linfenggg/aom_sync_clock/README.txt

2024-10-31  LD_CUR_FACTOR 值由2.5->2.9   因为DAC比例问题调整
