linfenggg/aom_sync_clock/User/readme.txt

//v1
初版

//v2
1.ld1通道切换
2.pwm 起始给个30%占空比,避免进入休眠模式
3.增加pwm下限
