linfenggg/aom_sync_clock/CTRL_V2 OPA-20260515/_版本说明.txt

//-------------MASTER_FPGA_V2103------------
1.模拟量一直输出，用TTL信号来选单
//-------------MASTER_FPGA_V2104------------
1.慢开慢关，一键开关调试
//-------------MASTER_FPGA_V2105------------
1.增加常规trig功能
2.通过模式实现功率控制自由切换，声光控制自由切换
3.PD2可以选择在AP1开启或者AP2开启后 监控（待定？）
4.任意一个欠压告警触发后，不再检测其他欠压告警
5.AOM2 DAC做最大值限制
6.添加电机在线告警
7.AOM2溢出修复
8.AOM2 TTL改为低开高关
//-------------MASTER_FPGA_V2106------------
1.新版本 未做更改
//-------------MASTER_FPGA_V2107------------
1.free trigger从trigger信号到光出来的时间固定
//-------------MASTER_FPGA_V2108------------
1.15个pump开关顺序自由调整调试
//-------------MASTER_FPGA_V2109------------
1.pump1开到目标值后开始检测PD1告警
2.pump2开到目标值后开始检测PD2告警
3.关泵2过程中，开始不检测PD2告警
4.关泵1过程中，开始不检测PD1告警
5.功率校准10%以下增加3%和6%两段
//-------------MASTER_FPGA_V2110------------
1.PD信号的pll添加复位信号，种子开启复位pll
2.对PD的pll输出进行喂狗检测，喂狗低于1M的告警，告警位bit[9]
3.修复常规模式跳级开pump开不起来，等前级pump开启后，跳级开的pump自动开bug
4.pump1开到目标值后，连续3s测频正常认为锁模成功，才允许开下一级
//-------------MASTER_FPGA_V2111------------
1.新增锁模告警，bit[31]，告警时缓慢关闭pump1
//-------------MASTER_FPGA_V2112------------
1.PD信号硬件不做展宽，在FPGA内部展宽
2.新增寄存器119，控制PD1脉宽展宽程度0-5可调
3.新增寄存器120，控制PD2脉宽展宽程度0-5可调
//-------------MASTER_FPGA_V2113------------
1.编译新版本号
//-------------MASTER_FPGA_V2114------------
1.功率校准新增校准起始点
//-------------MASTER_FPGA_V2115------------
1.pump 1-15开关顺序可以自由可调
//-------------MASTER_FPGA_V2117------------
1.优化AOM2控制方案，AOM2用PD倍频时钟触发
//-------------MASTER_FPGA_V2118------------
1.对声光输入控制量加K值，限制声光最大值
2.二级声光延时分free trig和常规模式两个参数
3.优化二级声光控制方式，改为和皮秒一样
4.优化电机溢出告警
//-------------MASTER_FPGA_V2120------------
1.直接从2118升级到2120
2.优化pump关闭的判定，pump sw==0并且电流==0才认为关闭
3.优化pump优先级开关问题，开和关的判定分开
//-------------MASTER_FPGA_V2122------------
1.free trigger后凹坑的长度可调
2.free trigger模式PD2不检测告警
//-------------MASTER_FPGA_V2123------------
1修复功率校准死区0%点位(原来为6bit，改为10bit)。
//-------------MASTER_FPGA_V2124------------
1. 修复功率校准死区0%点位(原来为6bit，改为10bit)。
2. 修复外部模拟量采集部分代码，模拟量采集后(0-2V)，需要乘以1.25，换算成2V对应255数字量。
	
//-------------MASTER_FPGA_V5000------------
1.兼容光纤激光器：种子-AP1-AP2-AP3(电流控制功率)。
2.新增ICR控制代码。

//-------------MASTER_FPGA_V5001------------
1.修复外部模拟量采集部分代码，模拟量采集后(0-2V)，需要乘以1.25，换算成2V对应255数字量。

//-------------MASTER_FPGA_V5002------------
1.修改一级声光延时和二级声光延时部分代码；
2.在AP OK后，延时100ms光正常后，再判断PD2测频低报警；
3.motor3和4屏蔽代码。
