linfenggg/aom_sync_clock/CTRL_V2 OPA-20260515/SchematicImage.png

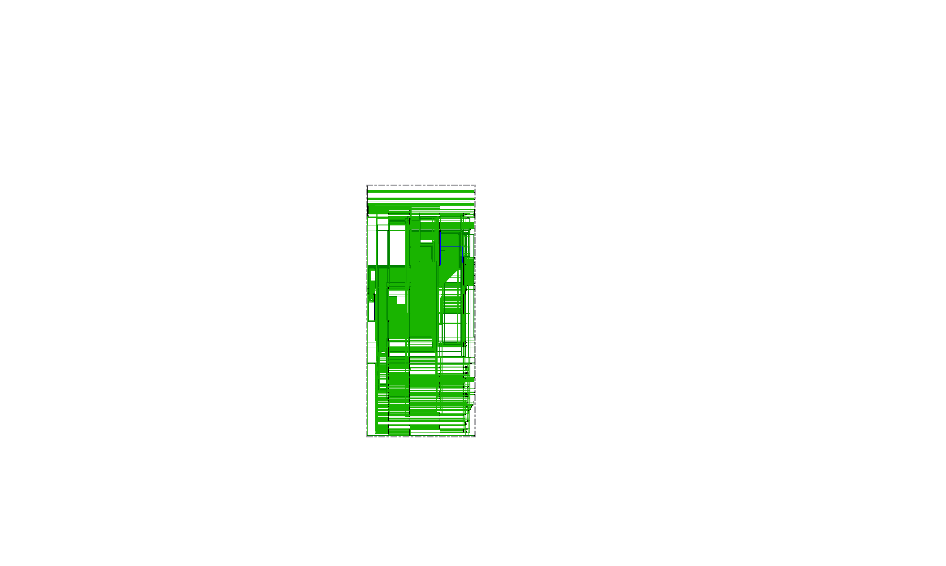
CTRL_V2 OPA-20260515/SchematicImage.png
