linfenggg/aom_sync_clock/(list of files, cad)

Other CAD files:
CTRL_V2 OPA-20260515/src/sim/work/@p@c@a9555/verilog.psm
CTRL_V2 OPA-20260515/src/sim/work/burst/verilog.psm
CTRL_V2 OPA-20260515/src/sim/work/cnt_delay/verilog.psm
CTRL_V2 OPA-20260515/src/sim/work/motor/verilog.psm
CTRL_V2 OPA-20260515/src/sim/work/tb_@p@c@a9555/verilog.psm
CTRL_V2 OPA-20260515/src/sim/work/tb_burst/verilog.psm
CTRL_V2 OPA-20260515/src/sim/work/tb_cnt_delay/verilog.psm
CTRL_V2 OPA-20260515/src/sim/work/tb_motor/verilog.psm
