linfenggg/aom_sync_clock/CTRL_V2 OPA-20260515/src/AND_DELAY.v

`timescale 1ns/1ns

module AND_DELAY(
	dly_in,
	dly_out,
	line,
	dly_num
);

input dly_in;
input[7:0] dly_num;			//延时参数
input line;
output dly_out;

(*keep*) wire t1;		(*keep*) wire t65 ;		//(*keep*) wire t129;		 (*keep*) wire t193;	
(*keep*) wire t2;       (*keep*) wire t66 ;     //(*keep*) wire t130;      (*keep*) wire t194;
(*keep*) wire t3;       (*keep*) wire t67 ;     //(*keep*) wire t131;      (*keep*) wire t195;
(*keep*) wire t4;       (*keep*) wire t68 ;     //(*keep*) wire t132;      (*keep*) wire t196;
(*keep*) wire t5;       (*keep*) wire t69 ;     //(*keep*) wire t133;      (*keep*) wire t197;
(*keep*) wire t6;       (*keep*) wire t70 ;     //(*keep*) wire t134;      (*keep*) wire t198;
(*keep*) wire t7;       (*keep*) wire t71 ;     //(*keep*) wire t135;      (*keep*) wire t199;
(*keep*) wire t8;       (*keep*) wire t72 ;     //(*keep*) wire t136;      (*keep*) wire t200;
(*keep*) wire t9;       (*keep*) wire t73 ;     //(*keep*) wire t137;      (*keep*) wire t201;
(*keep*) wire t10;      (*keep*) wire t74 ;     //(*keep*) wire t138;      (*keep*) wire t202;
(*keep*) wire t11;      (*keep*) wire t75 ;     //(*keep*) wire t139;      (*keep*) wire t203;
(*keep*) wire t12;      (*keep*) wire t76 ;     //(*keep*) wire t140;      (*keep*) wire t204;
(*keep*) wire t13;      (*keep*) wire t77 ;     //(*keep*) wire t141;      (*keep*) wire t205;
(*keep*) wire t14;      (*keep*) wire t78 ;     //(*keep*) wire t142;      (*keep*) wire t206;
(*keep*) wire t15;      (*keep*) wire t79 ;     //(*keep*) wire t143;      (*keep*) wire t207;
(*keep*) wire t16;      (*keep*) wire t80 ;     //(*keep*) wire t144;      (*keep*) wire t208;
(*keep*) wire t17;      (*keep*) wire t81 ;     //(*keep*) wire t145;      (*keep*) wire t209;
(*keep*) wire t18;      (*keep*) wire t82 ;     //(*keep*) wire t146;      (*keep*) wire t210;
(*keep*) wire t19;      (*keep*) wire t83 ;     //(*keep*) wire t147;      (*keep*) wire t211;
(*keep*) wire t20;      (*keep*) wire t84 ;     //(*keep*) wire t148;      (*keep*) wire t212;
(*keep*) wire t21;      (*keep*) wire t85 ;     //(*keep*) wire t149;      (*keep*) wire t213;
(*keep*) wire t22;      (*keep*) wire t86 ;     //(*keep*) wire t150;      (*keep*) wire t214;
(*keep*) wire t23;      (*keep*) wire t87 ;     //(*keep*) wire t151;      (*keep*) wire t215;
(*keep*) wire t24;      (*keep*) wire t88 ;     //(*keep*) wire t152;      (*keep*) wire t216;
(*keep*) wire t25;      (*keep*) wire t89 ;     //(*keep*) wire t153;      (*keep*) wire t217;
(*keep*) wire t26;      (*keep*) wire t90 ;     //(*keep*) wire t154;      (*keep*) wire t218;
(*keep*) wire t27;      (*keep*) wire t91 ;     //(*keep*) wire t155;      (*keep*) wire t219;
(*keep*) wire t28;      (*keep*) wire t92 ;     //(*keep*) wire t156;      (*keep*) wire t220;
(*keep*) wire t29;      (*keep*) wire t93 ;     //(*keep*) wire t157;      (*keep*) wire t221;
(*keep*) wire t30;      (*keep*) wire t94 ;     //(*keep*) wire t158;      (*keep*) wire t222;
(*keep*) wire t31;      (*keep*) wire t95 ;     //(*keep*) wire t159;      (*keep*) wire t223;
(*keep*) wire t32;      (*keep*) wire t96 ;     //(*keep*) wire t160;      (*keep*) wire t224;
(*keep*) wire t33;      (*keep*) wire t97 ;     //(*keep*) wire t161;      (*keep*) wire t225;
(*keep*) wire t34;      (*keep*) wire t98 ;     //(*keep*) wire t162;      (*keep*) wire t226;
(*keep*) wire t35;      (*keep*) wire t99 ;     //(*keep*) wire t163;      (*keep*) wire t227;
(*keep*) wire t36;      (*keep*) wire t100;     //(*keep*) wire t164;      (*keep*) wire t228;
(*keep*) wire t37;      (*keep*) wire t101;     //(*keep*) wire t165;      (*keep*) wire t229;
(*keep*) wire t38;      (*keep*) wire t102;     //(*keep*) wire t166;      (*keep*) wire t230;
(*keep*) wire t39;      (*keep*) wire t103;     //(*keep*) wire t167;      (*keep*) wire t231;
(*keep*) wire t40;      (*keep*) wire t104;     //(*keep*) wire t168;      (*keep*) wire t232;
(*keep*) wire t41;      (*keep*) wire t105;     //(*keep*) wire t169;      (*keep*) wire t233;
(*keep*) wire t42;      (*keep*) wire t106;     //(*keep*) wire t170;      (*keep*) wire t234;
(*keep*) wire t43;      (*keep*) wire t107;     //(*keep*) wire t171;      (*keep*) wire t235;
(*keep*) wire t44;      (*keep*) wire t108;     //(*keep*) wire t172;      (*keep*) wire t236;
(*keep*) wire t45;      (*keep*) wire t109;     //(*keep*) wire t173;      (*keep*) wire t237;
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
    223 :	out = t223      ;
    224 :	out = t224      ;
    225 :	out = t225      ;
    226 :	out = t226      ;
    227 :	out = t227      ;
    228 :	out = t228      ;
	229 :	out = t229      ;
	230 :	out = t230      ;
	231 :	out = t231      ;
	232 :	out = t232      ;
	233 :	out = t233      ;
	234 :	out = t234      ;
	235 :	out = t235      ;
	236 :	out = t236      ;
	237 :	out = t237      ;
	238 :	out = t238      ;
	239 :	out = t239      ;
	240 :	out = t240      ;
	241 :	out = t241      ;
	242 :	out = t242      ;
	243 :	out = t243      ;
	244 :	out = t244      ;
	245 :	out = t245      ;
	246 :	out = t246      ;
	247 :	out = t247      ;
	248 :	out = t248      ;
	249 :	out = t249      ;
	250 :	out = t250      ;
	251 :	out = t251      ;
	252 :	out = t252      ;
	253 :	out = t253      ;
	254 :	out = t254      ;
	255 :	out = t255      ;*/
	
	
	default out = dly_in;
    endcase

assign dly_out =  out ;  

endmodule 
