linfenggg/aom_sync_clock/CTRL_V2 OPA-20260515/src/reg_delay.v

module reg_delay(
	input 			clk_i,
	input 			dly_in,
	input [7:0]		dly_num,
	output reg		dly_out
);
//delay
(*keep*) reg delay0,delay1,delay2,delay3,delay4,delay5,delay6,delay7,delay8,delay9;
(*keep*) reg delay10,delay11,delay12,delay13,delay14,delay15,delay16,delay17,delay18,delay19;
(*keep*) reg delay20,delay21,delay22,delay23,delay24,delay25,delay26,delay27,delay28,delay29;
(*keep*) reg delay30,delay31,delay32,delay33,delay34,delay35,delay36,delay37,delay38,delay39;
(*keep*) reg delay40,delay41,delay42,delay43,delay44,delay45,delay46,delay47,delay48,delay49;
(*keep*) reg delay50,delay51,delay52,delay53,delay54,delay55,delay56,delay57,delay58,delay59;
(*keep*) reg delay60,delay61,delay62,delay63,delay64,delay65,delay66,delay67,delay68,delay69;
(*keep*) reg delay70,delay71,delay72,delay73,delay74,delay75,delay76,delay77,delay78,delay79;
(*keep*) reg delay80,delay81,delay82,delay83,delay84,delay85,delay86,delay87,delay88,delay89;
(*keep*) reg delay90,delay91,delay92,delay93,delay94,delay95,delay96,delay97,delay98,delay99;
(*keep*) reg delay100,delay101,delay102,delay103,delay104,delay105,delay106,delay107,delay108,delay109;
(*keep*) reg delay110,delay111,delay112,delay113,delay114,delay115,delay116,delay117,delay118,delay119;
(*keep*) reg delay120,delay121,delay122,delay123,delay124,delay125,delay126,delay127,delay128,delay129;
(*keep*) reg delay130,delay131,delay132,delay133,delay134,delay135,delay136,delay137,delay138,delay139;
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
    249: dly_out <= delay248 ;
    250: dly_out <= delay249 ;
    251: dly_out <= delay250 ;
    252: dly_out <= delay251 ;
    253: dly_out <= delay252 ;
    254: dly_out <= delay253 ;
    255: dly_out <= delay254 ;
	default : dly_out <= dly_in ;
	endcase
end
endmodule 
