linfenggg/aom_sync_clock/CTRL_V2 OPA-20260515/MASTER_FPGA_Runs/phy_1/MASTER_FPGA_watcherInst.sv

module CW_TOP_WRAPPER(jtdi, jtck, jrstn, jscan, jshift, jupdate, jtdo, trig_clk, bus_din, wt_ce, wt_en, wt_addr);
	localparam STAT_REG_LEN = 18;
	localparam BUS_NUM = 10;
	localparam BUS_DIN_NUM = 66;
	localparam BUS_CTRL_NUM = 172;
	localparam integer BUS_WIDTH[0:9] = {1,16,4,3,16,4,1,1,16,4};
	localparam integer BUS_DIN_POS[0:9] = {0,1,17,21,24,40,44,45,46,62};
	localparam integer BUS_CTRL_POS[0:9] = {0,6,42,54,64,100,112,118,124,160};

	input jtdi;
	input jtck;
	input jrstn;
	input [1:0] jscan;
	input jshift;
	input jupdate;
	output [1:0] jtdo;
	input trig_clk;
	input [BUS_DIN_NUM-1:0] bus_din;
	output wt_ce;
	output wt_en;
	output [15:0] wt_addr;

	cwc_top #(
		.STAT_REG_LEN(STAT_REG_LEN),
		.BUS_NUM(BUS_NUM),
		.BUS_DIN_NUM(BUS_DIN_NUM),
		.BUS_CTRL_NUM(BUS_CTRL_NUM),
		.BUS_WIDTH(BUS_WIDTH),
		.BUS_DIN_POS(BUS_DIN_POS),
		.BUS_CTRL_POS(BUS_CTRL_POS)
	)
	 wrapper_cwc_top(
		.jtdi(jtdi),
		.jtck(jtck),
		.jrstn(jrstn),
		.jscan(jscan),
		.jshift(jshift),
		.jupdate(jupdate),
		.jtdo(jtdo),
		.bus_din(bus_din),
		.trig_clk(trig_clk),
		.wt_ce(wt_ce),
		.wt_en(wt_en),
		.wt_addr(wt_addr)
	);
endmodule
