linfenggg/aom_sync_clock/DRV/gpio.h

/* USER CODE END Header */
/* Define to prevent recursive inclusion -------------------------------------*/
#ifndef __GPIO_H__
#define __GPIO_H__

#ifdef __cplusplus
extern "C" {
#endif

/* Includes ------------------------------------------------------------------*/
#include "main.h"
#include "gd32f10x.h"


/* Private defines -----------------------------------------------------------*/



void MX_GPIO_Init(void);


#ifdef __cplusplus
}
#endif
#endif /*__ GPIO_H__ */
