linfenggg/aom_sync_clock/CTRL_V2 OPA-20260515/al_ip/SYS_PLL_sim.v

// Verilog netlist created by TD v5.0.38657
// Mon Apr 24 17:16:49 2023

`timescale 1ns / 1ps
module SYS_PLL  // SYS_PLL.v(24)
  (
  refclk,
  reset,
  clk0_out,
  clk1_out,
  clk2_out,
  extlock
  );

  input refclk;  // SYS_PLL.v(31)
  input reset;  // SYS_PLL.v(32)
  output clk0_out;  // SYS_PLL.v(34)
  output clk1_out;  // SYS_PLL.v(35)
  output clk2_out;  // SYS_PLL.v(36)
  output extlock;  // SYS_PLL.v(33)

  wire clk0_buf;  // SYS_PLL.v(38)

  EG_PHY_GCLK bufg_feedback (
    .clki(clk0_buf),
    .clko(clk0_out));  // SYS_PLL.v(40)
  EG_PHY_CONFIG #(
    .DONE_PERSISTN("ENABLE"),
    .INIT_PERSISTN("ENABLE"),
    .JTAG_PERSISTN("DISABLE"),
    .PROGRAMN_PERSISTN("DISABLE"))
    config_inst ();
  EG_PHY_PLL #(
    .CLKC0_CPHASE(15),
    .CLKC0_DIV(16),
    .CLKC0_DIV2_ENABLE("DISABLE"),
    .CLKC0_ENABLE("ENABLE"),
    .CLKC0_FPHASE(0),
    .CLKC1_CPHASE(4),
    .CLKC1_DIV(5),
    .CLKC1_DIV2_ENABLE("DISABLE"),
    .CLKC1_ENABLE("ENABLE"),
    .CLKC1_FPHASE(0),
    .CLKC2_CPHASE(7),
    .CLKC2_DIV(8),
    .CLKC2_DIV2_ENABLE("DISABLE"),
    .CLKC2_ENABLE("ENABLE"),
    .CLKC2_FPHASE(0),
    .CLKC3_CPHASE(1),
    .CLKC3_DIV(1),
    .CLKC3_DIV2_ENABLE("DISABLE"),
    .CLKC3_ENABLE("DISABLE"),
    .CLKC3_FPHASE(0),
    .CLKC4_CPHASE(1),
    .CLKC4_DIV(1),
    .CLKC4_DIV2_ENABLE("DISABLE"),
    .CLKC4_ENABLE("DISABLE"),
    .CLKC4_FPHASE(0),
    .DERIVE_PLL_CLOCKS("DISABLE"),
    .DPHASE_SOURCE("DISABLE"),
    .DYNCFG("DISABLE"),
    .FBCLK_DIV(1),
    .FEEDBK_MODE("NORMAL"),
    .FEEDBK_PATH("CLKC0_EXT"),
    .FIN("50.000"),
    .FREQ_LOCK_ACCURACY(2),
    .GEN_BASIC_CLOCK("DISABLE"),
    .GMC_GAIN(4),
    .GMC_TEST(14),
    .ICP_CURRENT(13),
    .IF_ESCLKSTSW("DISABLE"),
    .INTFB_WAKE("DISABLE"),
    .KVCO(4),
    .LPF_CAPACITOR(1),
    .LPF_RESISTOR(4),
    .NORESET("DISABLE"),
    .ODIV_MUXC0("DIV"),
    .ODIV_MUXC1("DIV"),
    .ODIV_MUXC2("DIV"),
    .ODIV_MUXC3("DIV"),
    .ODIV_MUXC4("DIV"),
    .PLLC2RST_ENA("DISABLE"),
    .PLLC34RST_ENA("DISABLE"),
    .PLLMRST_ENA("DISABLE"),
    .PLLRST_ENA("ENABLE"),
    .PLL_LOCK_MODE(0),
    .PREDIV_MUXC0("VCO"),
    .PREDIV_MUXC1("VCO"),
    .PREDIV_MUXC2("VCO"),
    .PREDIV_MUXC3("VCO"),
    .PREDIV_MUXC4("VCO"),
    .REFCLK_DIV(1),
    .REFCLK_SEL("INTERNAL"),
    .STDBY_ENABLE("DISABLE"),
    .STDBY_VCO_ENA("DISABLE"),
    .SYNC_ENABLE("DISABLE"),
    .VCO_NORESET("DISABLE"))
    pll_inst (
    .daddr(6'b000000),
    .dclk(1'b0),
    .dcs(1'b0),
    .di(8'b00000000),
    .dwe(1'b0),
    .fbclk(clk0_out),
    .load_reg(1'b0),
    .psclk(1'b0),
    .psclksel(3'b000),
    .psdown(1'b0),
    .psstep(1'b0),
    .refclk(refclk),
    .reset(reset),
    .stdby(1'b0),
    .clkc({open_n47,open_n48,clk2_out,clk1_out,clk0_buf}),
    .extlock(extlock));  // SYS_PLL.v(71)

endmodule 
