linfenggg/aom_sync_clock/(commit log)

2026-05-02 添加 .gitattributes 和 .gitignore。
2026-05-02 添加项目文件。
2026-05-02 Fix HMC830 HMC bit output and ID read flow
    [drv_hmc830lp6ge.c]
2026-05-03 Refine HMC830 HMC-mode driver flow
2026-05-03 Adjust HMC830 init and readback flow
