linfenggg/aom_sync_clock/(notices)

Notices in the files:
DRV/usart.c:
Copyright (c) 2022 STMicroelectronics.
All rights reserved.
This software is licensed under terms that can be found in the LICENSE file
